x86fr/ATX2AT-Smart-Converter/Schematics/ATX2AT Smart Converter 1.02.pdf

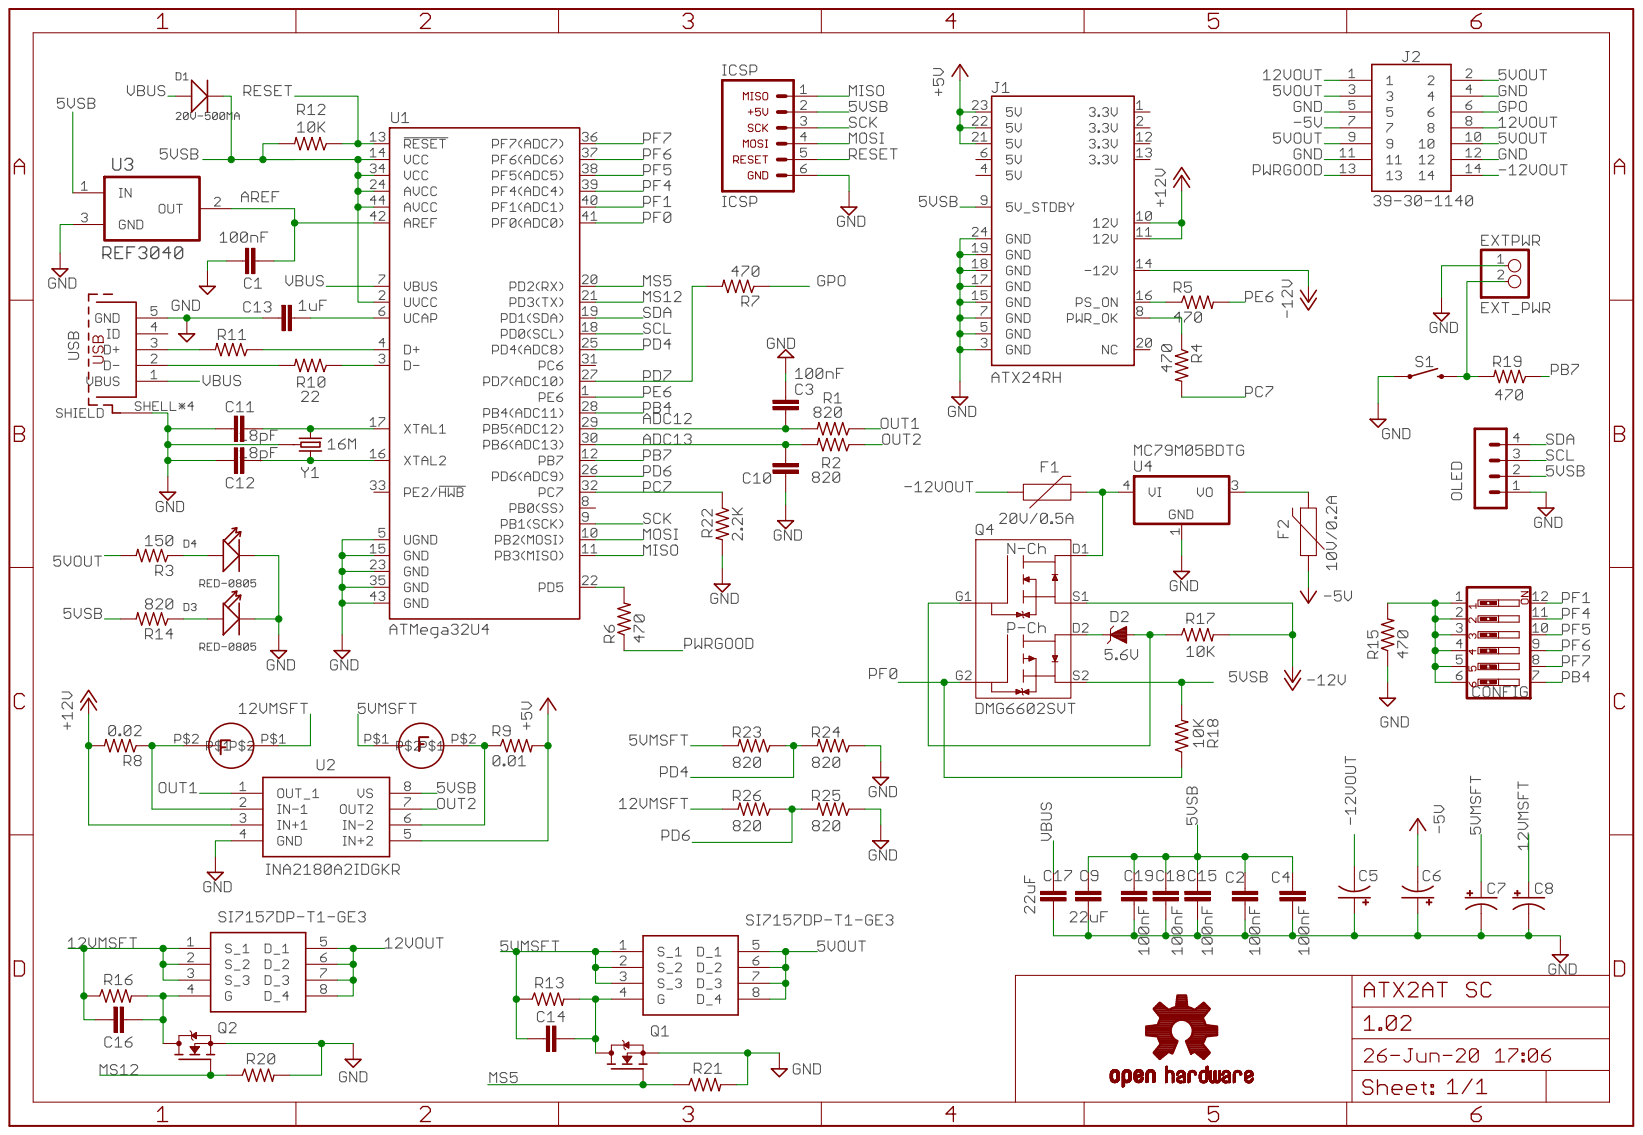
[picture p1: page 1]
