x86fr/ATX2AT-Smart-Converter/(threads)

Thread 1 (2020-06-29):

BOM part number 25 value is not defined

jacktronics, 2020-06-29:
The capacitor C14 / C16 have a non defined value, still listed as TBD, can you update it with the final value please ?

x86fr, 2020-06-29:
Sure. And there is also some minors changes on the BOM. I will commit the final version within one hour.

The 1.12 firmware is also bugged (typo on +12V over-current detection). The final FW that shipped is 1.13. I will upload it tomorrow

x86fr, 2020-06-29:
Fixed!

jacktronics, 2020-06-30:
Thanks, the BOM looks better now, thanks for uploading the newer firmware too. closing this issue.

Closed 2020-06-30.

Thread 2 (2020-10-05):

Mount SMD file

draget, 2020-10-05:
Are the original EAGLE files or the "Mount SMD" file export available?

Thanks

ajacocks, 2021-12-26:
Do you mean the pick-an-place specification file? If so, yes, that would be handy.

JLCPCB calls it a “.cpl” file.

Thread 5 (2021-10-30):

BOM error or assemble error?

perchrh, 2021-10-30:
Trying out my ATX2AT device from the Kickstarter, for the first time.
I got no power on the 12V output line, so I investigated and found a fuse to be blown.
Looking at the BOM to order a replacement, there are two issues.

1) The component is listed as 'OMNIFUSE 0154005', while the real name is 'Littlefuse OMNI-BLOK 154005.0'. Goes for both F3 and F4 (154010.0).
2) The values for F3 and F4 are switched. The F4 is connected to 12V and should have the 5A fuse.

If you like, I can send a pull request for these changes, if they look correct to you as well. Alternatively, you make the changes :)

x86fr, 2021-11-03:
Hi there,

That’s correct (except that it’s “LITTELFUSE” not “LITTLEFUSE”).

Yes, you can send a pull request. 😊

154005.0 is the P/N for fuse holder w/ fuse.

If you need it, the fuse alone is :

5A: Littelfuse NANO2 0451005.MRL

10A: Littelfuse NANO2 0451010.MRL

Thank you !

Sam.

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

perchrh, 2021-11-03:
Yes, using a replacement fuse of that type made it work. Nice! :)

Closed 2021-11-03.

Thread 7 (2022-11-18):

BOM does not pass PCBWay review process

baconsmokeco, 2022-11-18:
The BOM is not complete according to PCBWay. I sent them the BOM to have them build it and they came back with quite a few questions. It's obvious this project is for people much smarter than myself. So, that's on me for even attempting to try this. But the questions they are asking are way over my ability to answer. Perhaps nothing needs to be changed, but I thought it was worthwhile bringing up that the BOM as is, will not pass PCBWay's review process. Some of the questions they ask are about inventory warnings and minimum order quantities. Which obviously are not an issue, but there are seven lines on the BOM that need clarification. I am including what they sent me. Again, if I was savvy about this stuff, maybe the questions are childish and easy. But I'm too dumb to know. Sorry.

[T-1P2W535888A-1sets-ATX2AT_SC_1.02_2020-03-04_BOM_PROD(2022-11-18).xls](https://github.com/x86fr/ATX2AT-Smart-Converter/files/10037428/T-1P2W535888A-1sets-ATX2AT_SC_1.02_2020-03-04_BOM_PROD.2022-11-18.xls)

str4d, 2023-01-08:
Half of the issues they raise are basically substitutions they are proposing they make, likely as they can't source the specified parts. But some of them are issues with the BOM (that I've also encountered, and am tracking in #8).

- `REF3030AIDBZR` - "[moq=10];"
  - No idea what this means; it's probably just an internal PCBWay note, not something they are asking you.
- `DMG6602SVT` - "Please provide exact part number."
  - My part picker also complained about the part number. AFAICT this is the DiodesZetex DMG6602SVT-7; I have not figured out what the `-7` means to DiodesZetex.
- `OMNI-BLOK 154010.0 / OMNI-BLOK 154005.0` - "Is it fuse?"
  - They have made a similar mistake to what I noted in #8, and appear to be proposing to purchase the replacement fuses (`0451010.MRL / 0451005.MRL`) for which the part numbers in the comments were correct, not the fuses + holders (`0154010.DR / 0154005.DR`) for which the BOM used catalogue numbers. You want `0154010.DR / 0154005.DR`.
- `B0520LW` - "The part we will supply is made by CJ，B0520LW（250uA@20V 20V Single 0.39V@0.5A 0.5A SOD-123 Schottky Barrier Diodes），ok？Only 230pcs total in stock, please confirm ASAP."
  - This is a suggested replacement, for which they are listing its electrical characteristics. It looks compatible with [the DiodesZetex version](https://docs.rs-online.com/3f32/0900766b80e30cea.pdf).
- `MMSZ5232BS` - "The part we will supply is made by CJ，MMSZ5232BS（5uA@3V 11Ω Single 5.32V~5.88V 200mW 5.6V SOD-323 Zener Diodes），ok？"
  - Also a replacement. It looks compatible with [the DiodesZetex version](https://docs.rs-online.com/6e05/0900766b81321dde.pdf).
- `22uF 16V 0805 X7R Ceramic Capacitor (+5V Internal Decoupling caps)` - "X5R，ok？"
  - They are asking whether it is okay to use a part with X5R dielectric instead of X7R dielectric. [Here is an explainer about ceramic capacitor codes](https://www.allaboutcircuits.com/technical-articles/x7r-x5r-c0g...-a-concise-guide-to-ceramic-capacitor-types/). The difference is that X7R is rated up to 125°C while X5R is only rated up to 85°C. But they both allow ±15% change of capacitance over that temperature range, and these capacitors are used for smoothing the 5VSB and VBUS line voltages, so assuming your environment doesn't get particularly hot X5R is probably fine.
- `LR2512-23R010F4` - "Only 280pcs total in stock, please confirm ASAP."
  - I think this is just letting you know that they found this part, but they need the overall BOM confirmed quickly as supply is limited of this part.
- `10K Ohm 0603 Resistor (Pullup/down)` - "Qty：8？"
  - Same issue I noted in #8; yes you want 8, not 7.
- `A2541HWV-4P` - "There are 2 kinds diameter. What we quoted is C5176037， diameter is 1.19mm, not plated gold. Please check .(C225501 -1.19, plated gold/ C5144876 - 0.064mm)Please tell which one you need"
  - I _think_ what they are asking is to confirm whether this PIN header should have 1.19mm or 0.64mm PINs (both for connecting into the PCB and for connecting to the OLED display). Pretty sure you want 0.64mm here, as that's pretty standard for headers with 0.1" PIN spacing (vs 1.19mm which I think the MOLEX connector to the ATX power supply uses), but I can't confirm without knowing the OLED display model (which is not specified: #9).

Thread 8 (2023-01-08):

BOM issues

str4d, 2023-01-08:
I am attempting to make the BOM compatible with the automated scanner for [PCB Train](https://www.pcbtrain.co.uk), and am documenting the issues I encounter. I'll make a PR to address them once I get a working BOM.

- Their scanner wants separate "Manufacturer" and "Manufacturer Part Number" columns, and passing the "Device" column (which contains both for some parts) as the latter gives fewer matching results than splitting it into two columns.
- `10K Ohm 0402 Resistor` has eight Designators, but only "Quantity: 7".
- Littelfuse part numbers don't appear to match the manufacturer website. OMNI-BLOK 154010.0 and 154005.0 are the Littelfuse catalogue numbers, but per [the 154 datasheet's part numbering system](https://www.littelfuse.com/media?itemid=1cd64ad0-b793-4012-8c75-7e2fefbc1368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), these should instead use [0154010.DR](https://www.littelfuse.com/products/fuse-blocks-fuseholders-and-fuse-accessories/fuse-blocks/154/154010_dr.aspx) and [0154005.DR](https://www.littelfuse.com/products/fuse-blocks-fuseholders-and-fuse-accessories/fuse-blocks/154/154005_dr.aspx) to indicate that they are the "Very Fast-Acting (FF)" fuse type (instead of [0154005.DRT](https://www.littelfuse.com/products/fuse-blocks-fuseholders-and-fuse-accessories/fuse-blocks/154/0154005_drt.aspx) or [0154005.DRTL](https://www.littelfuse.com/products/fuse-blocks-fuseholders-and-fuse-accessories/fuse-blocks/154/0154005_drtl.aspx), which are "Slo-Blo/Time Lag (T)/Time Delay" fuses; the automated scanner selected 0154005.DRT initially).
- It would be helpful to provide example manufacturers for the standard parts, so that the automated scanners can figure out what they are (and maybe suggest alternatives, IDK if they do).

str4d, 2023-01-22:
Measuring between the middle of pads on the Gerber files, I see:

- R10, R11: 1.6mm
- R3, R14: 1.6mm
- R12, R22: 1mm

The BOM consistently lists R10 and R11 as an 0603 package, and 1.6mm is the length of an imperial 0603 package (vs a metric 0603 which would be 0.6mm). Assuming all resistors are using imperial package numbers, that means the "Device" column in the BOM is correct (and the "Description" column is incorrect): `R3, R14` are 0603, and `R12` etc. are 0402.

str4d, 2023-01-22:
When I search Digi-Key, the only 22uF 0805 X7R Ceramic Capacitor that comes up is [GRM21BZ71A226ME15L](https://www.digikey.co.uk/en/products/detail/murata-electronics/GRM21BZ71A226ME15L/13904953), which is rated to 10V. Given that the "Device" column was correct for the resistor BOM errors, I'm going to presume it is correct for `C9, C17` as well. They are described as "+5V Internal Decoupling caps", and you usually want 2-3x the target voltage to allow for spikes, so 10V _should_ be fine.

ints99, 2024-01-02:
Btw, R22 seems to be 2K2 on schematics, but 10K on BOM. I hope, 10K will actually work as well, as I soldered it already before noticing the difference...?

Thread 9 (2023-01-08):

Part number for OLED display is missing

str4d, 2023-01-08:
I've looked everywhere in this repo and can't find a part number for the OLED display. Makes sense it wouldn't be in the BOM (that just specifies the connector to the OLED), but the schematic doesn't list it either.

The firmware uses the [Adafruit_SSD1306](https://github.com/adafruit/Adafruit_SSD1306) library, instantiating it as:

https://github.com/x86fr/ATX2AT-Smart-Converter/blob/703dce9b71507b9083982ab6cb7058df82862da4/Firmware/1.21/ATX2AT.ino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

This indicates it is a 128x64 Adafruit OLED graphic display, but none of the displays in the [Adafruit product category](https://www.adafruit.com/category/63_98) linked from the library appear to match what the ATX2AT-SC is designed for.

str4d, 2023-01-08:
I notice that https://www.adafruit.com/product/326 (which looks very similar but has a different pinout and is monochrome, so doesn't match what ATX2AT-SC uses given the available photos) says that it was revised in August 2020. So maybe the product that ATX2AT-SC used was also revised then, or is no longer produced?

str4d, 2023-01-08:
I am also confused by the fact that the firmware indicates that the reset line is connected:

https://github.com/x86fr/ATX2AT-Smart-Converter/blob/703dce9b71507b9083982ab6cb7058df82862da4/Firmware/1.21/ATX2AT.ino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

But the schematic shows no wire from PD2 to the OLED header; instead PD2 goes to MS5 to control the +5V output line:

https://github.com/x86fr/ATX2AT-Smart-Converter/blob/703dce9b71507b9083982ab6cb7058df82862da4/Firmware/1.21/ATX2AT.ino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

str4d, 2023-01-22:
Okay, did a bit more research, and it looks like just searching for "I2C OLED SSD1306" is sufficient to pull up various parts that appear compatible (e.g. https://www.az-delivery.uk/en/products/0-96zolldisplay). I haven't confirmed yet whether the 0.96" form factor is standard for this screen or not; the main concern would be whether the mounting holes line up with those on the ATX2AT PCB.

str4d, 2023-12-17:
Something to be careful about is that the pinout should be (from left to right) `GND, VCC, SCL, SDA`. I've seen at least one seemingly-compatible part that reverses `GND` and `VCC` (i.e. a pinout of `VCC, GND, SCL, SDA`).

Thread 10 (2023-02-04):

Missing Q3 on schematic

jarzebski, 2023-02-04:
Hi, I'm trying to find Q3 (2N7002DW) on schematic. Is actual?

x86fr, 2023-02-04:
Hi, It's a Dual Channel MOSFET. Here are the two MOSFETs  from Q3 on the schematics :

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

Closed 2023-02-04.

Thread 11 (2023-02-14):

Boards à vendre

lazaj, 2023-02-14:
Je viens de tomber sur votre projet, un peu en retard ...
Je suis collectionneur d'ordi vintage et je propose aussi mes services en tant que restaurateur.
Vous resterez t-il une ou deux board à vendre ?

x86fr, 2023-02-15:
Pas pour l'instant. La pénurie de composant rend une nouvelle commande trés longue.

Closed 2023-02-15.

Thread 13 (2024-05-20):

Power good

ints99, 2024-05-20:
When having established USB connection, motherboard will loose power good for a moment, if USB data is read/written.

Thread 16 (2025-10-02):

Tantalum Capacitor in +12V main filtering

sztojanov, 2025-10-02:
`C8` seems to be 47 uF with 25V in description row but the part number suggesting 220 uF (`TAJE227K016RNJ`) Maybe both working...
