x86fr/ATX2AT-Smart-Converter/(commit log)

2020-06-26 Initial Commit for Shipping
    [ATX2AT_SC_1.02_2020-03-04_BOM_PROD.csv, ATX2AT_SC_1.02_2020-03-04_BOM_PROD.xlsx]
2020-06-29 BOM Correction
    [ATX2AT_SC_1.02_2020-03-04_BOM_PROD.csv, ATX2AT_SC_1.02_2020-03-04_BOM_PROD.xlsx]
2020-12-13 Updated fw version in EEPROM to 1.13 to match current firmware version.
2021-11-03 Corrections and additions for F3 and F4
    [ATX2AT_SC_1.02_2020-03-04_BOM_PROD.csv, ATX2AT_SC_1.02_2020-03-04_BOM_PROD.xlsx]
